YetAnotherElectronicsChannel/AES50/Hardware Design/KiCad Files/aes50_trion.kicad_pcb

## KiCad design Hardware Design/KiCad Files/aes50_trion.kicad_pcb (2026-08-12)

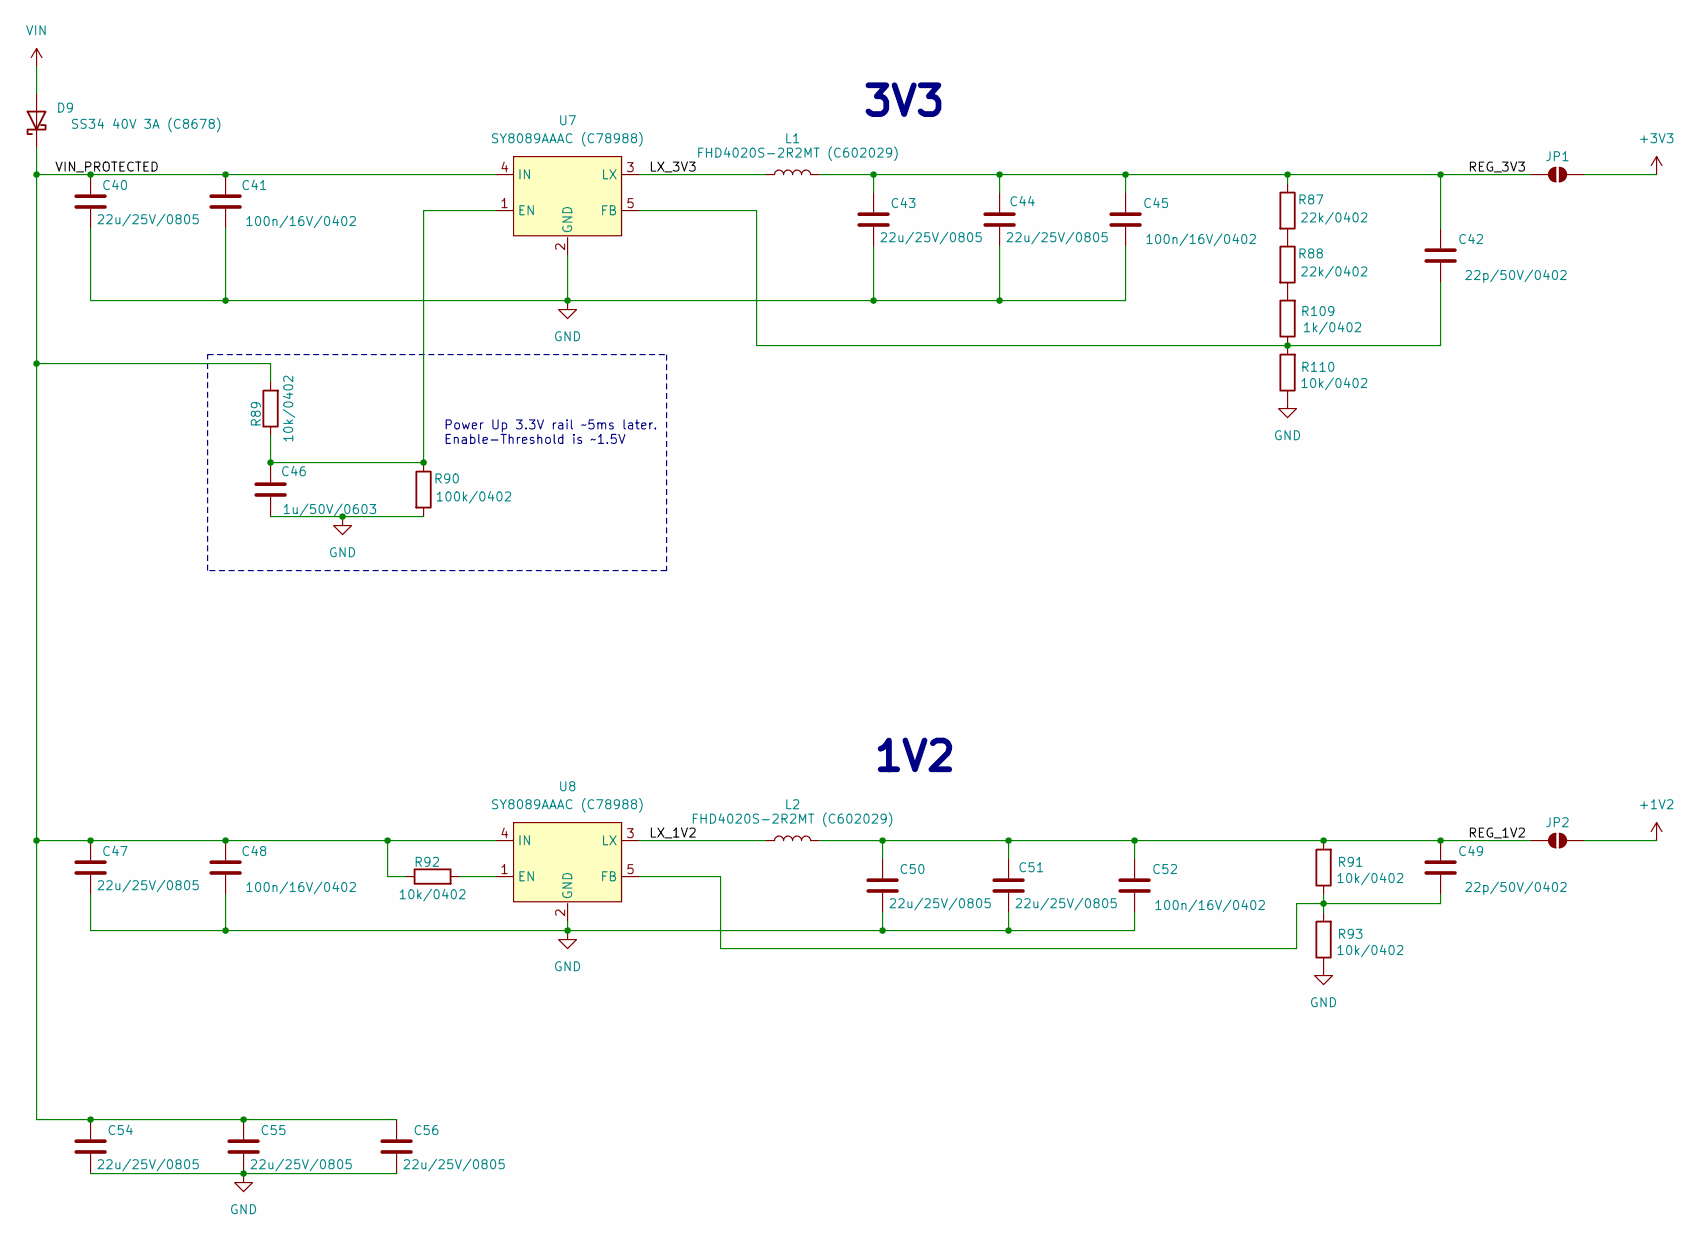
[picture p6: schematic Power.kicad_sch]

Parts:
C40, C43, C44, C47, C50, C51, C54, C55, C56: 22u/25V/0805; C_0805_2012Metric
C41, C45, C48, C52: 100n/16V/0402; C_0402_1005Metric
C42, C49: 22p/50V/0402; C_0402_1005Metric
C46: 1u/50V/0603; C_0603_1608Metric
D9: SS34 40V 3A (C8678); D_SMA
JP1, JP2: SolderJumper_2_Open; SolderJumper-2_P1.3mm_Open_RoundedPad1.0x1.5mm
L1, L2: FHD4020S-2R2MT (C602029); L_APV_ANR4020
R87, R88: 22k/0402; R_0402_1005Metric
R89, R91, R92, R93, R110: 10k/0402; R_0402_1005Metric
R90: 100k/0402; R_0402_1005Metric
R109: 1k/0402; R_0402_1005Metric
U7, U8: SY8089AAAC (C78988); SOT-23-5

Connections:
+1V2: JP2.2 (B); also elsewhere on the board
+3V3: JP1.2 (B); also elsewhere on the board
/Power/LX_1V2: L2.1, U8.3 (LX)
/Power/LX_3V3: L1.1, U7.3 (LX)
/Power/REG_1V2: C49.1, C50.1, C51.1, C52.1, JP2.1 (A), L2.2, R91.2
/Power/REG_3V3: C42.1, C43.1, C44.1, C45.1, JP1.1 (A), L1.2, R87.1
/Power/VIN_PROTECTED: C40.1, C41.1, C47.1, C48.1, C54.1, C55.1, C56.1, D9.1 (K), R89.2, R92.1, U7.4 (IN), U8.4 (IN)
GND: C40.2, C41.2, C43.2, C44.2, C45.2, C46.1, C47.2, C48.2, C50.2, C51.2, C52.2, C54.2, C55.2, C56.2, R90.2, R93.1, R110.1, U7.2 (GND), U8.2 (GND); also elsewhere on the board
unnamed: R87.2, R88.1
unnamed: R88.2, R109.2
unnamed: C46.2, R89.1, R90.1, U7.1 (EN)
unnamed: C42.2, R109.1, R110.2, U7.5 (FB)
unnamed: R92.2, U8.1 (EN)
unnamed: C49.2, R91.1, R93.2, U8.5 (FB)
VIN: D9.2 (A); also elsewhere on the board

Notes on the sheet:
3V3
1V2
Power Up 3.3V rail ~5ms later. Enable-Threshold is ~1.5V

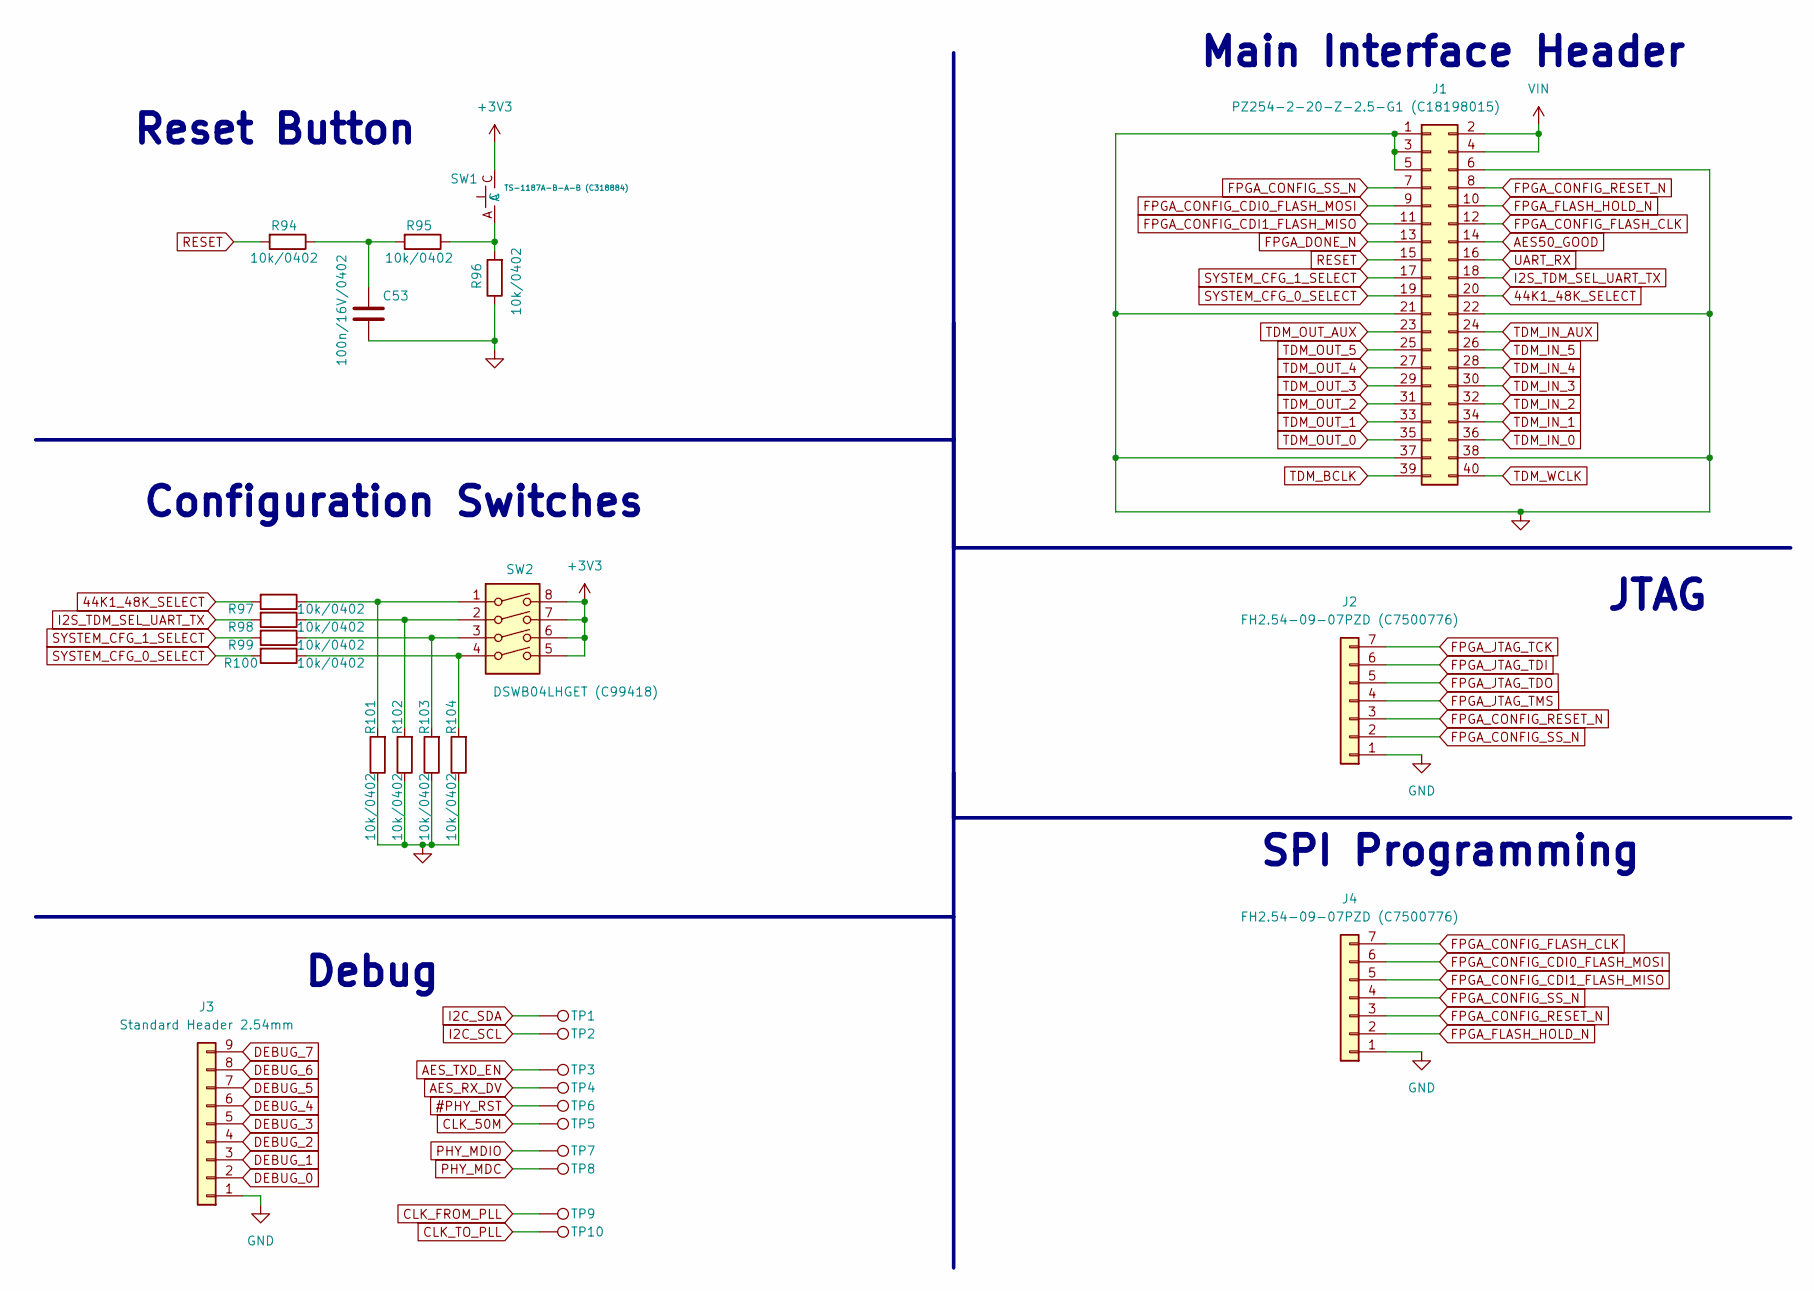
[picture p7: schematic Misc.kicad_sch]

Parts:
C53: 100n/16V/0402; C_0402_1005Metric
J1: PZ254-2-20-Z-2.5-G1 (C18198015); PinHeader_2x20_P2.54mm_Vertical
J2, J4: FH2.54-09-07PZD (C7500776); FH2.54-09-07PZD
J3: Standard Header 2.54mm; PinHeader_1x09_P2.54mm_Vertical
R94, R95, R96, R97, R98, R99, R100, R101, R102, R103, R104: 10k/0402; R_0402_1005Metric
SW1: TS-1187A-B-A-B (C318884); TS-1187A-B-A-B
SW2: DSWB04LHGET (C99418); DSWB04LHGET
TP1, TP2, TP3, TP4, TP5, TP6, TP7, TP8, TP9, TP10: TestPoint; TestPoint_Pad_D1.0mm

Connections:
44K1_48K_SELECT: J1.20, R97.2; also elsewhere on the board
#PHY_RST: TP6.1; also elsewhere on the board
+3V3: SW1.C, SW1.D, SW2.5, SW2.6, SW2.7, SW2.8; also elsewhere on the board
AES50_GOOD: J1.14; also elsewhere on the board
AES_RX_DV: TP4.1; also elsewhere on the board
AES_TXD_EN: TP3.1; also elsewhere on the board
CLK_50M: TP5.1; also elsewhere on the board
CLK_FROM_PLL: TP9.1; also elsewhere on the board
CLK_TO_PLL: TP10.1; also elsewhere on the board
DEBUG_0: J3.2; also elsewhere on the board
DEBUG_1: J3.3; also elsewhere on the board
DEBUG_2: J3.4; also elsewhere on the board
DEBUG_3: J3.5; also elsewhere on the board
DEBUG_4: J3.6; also elsewhere on the board
DEBUG_5: J3.7; also elsewhere on the board
DEBUG_6: J3.8; also elsewhere on the board
DEBUG_7: J3.9; also elsewhere on the board
FPGA_CONFIG_CDI0_FLASH_MOSI: J1.9, J4.6; also elsewhere on the board
FPGA_CONFIG_CDI1_FLASH_MISO: J1.11, J4.5; also elsewhere on the board
FPGA_CONFIG_FLASH_CLK: J1.12, J4.7; also elsewhere on the board
FPGA_CONFIG_RESET_N: J1.8, J2.3, J4.3; also elsewhere on the board
FPGA_CONFIG_SS_N: J1.7, J2.2, J4.4; also elsewhere on the board
FPGA_DONE_N: J1.13; also elsewhere on the board
FPGA_FLASH_HOLD_N: J1.10, J4.2; also elsewhere on the board
FPGA_JTAG_TCK: J2.7; also elsewhere on the board
FPGA_JTAG_TDI: J2.6; also elsewhere on the board
FPGA_JTAG_TDO: J2.5; also elsewhere on the board
FPGA_JTAG_TMS: J2.4; also elsewhere on the board
GND: C53.2, J1.1, J1.3, J1.5, J1.6, J1.21, J1.22, J1.37, J1.38, J2.1, J3.1, J4.1, R96.1, R101.1, R102.1, R103.1, R104.1; also elsewhere on the board
I2C_SCL: TP2.1; also elsewhere on the board
I2C_SDA: TP1.1; also elsewhere on the board
unnamed: C53.1, R94.1, R95.2
unnamed: R95.1, R96.2, SW1.A, SW1.B
unnamed: R100.1, R104.2, SW2.4
unnamed: R97.1, R101.2, SW2.1
unnamed: R98.1, R102.2, SW2.2
unnamed: R99.1, R103.2, SW2.3
PHY_MDC: TP8.1; also elsewhere on the board
PHY_MDIO: TP7.1; also elsewhere on the board
RESET: J1.15, R94.2; also elsewhere on the board
SPARE_SELECT_GPIO: J1.18, R98.2; also elsewhere on the board
SYSTEM_CFG_0_SELECT: J1.19, R100.2; also elsewhere on the board
SYSTEM_CFG_1_SELECT: J1.17, R99.2; also elsewhere on the board
TDM_BCLK: J1.39; also elsewhere on the board
TDM_IN_0: J1.36; also elsewhere on the board
TDM_IN_1: J1.34; also elsewhere on the board
TDM_IN_2: J1.32; also elsewhere on the board
TDM_IN_3: J1.30; also elsewhere on the board
TDM_IN_4: J1.28; also elsewhere on the board
TDM_IN_5: J1.26; also elsewhere on the board
TDM_IN_AUX: J1.24; also elsewhere on the board
TDM_OUT_0: J1.35; also elsewhere on the board
TDM_OUT_1: J1.33; also elsewhere on the board
TDM_OUT_2: J1.31; also elsewhere on the board
TDM_OUT_3: J1.29; also elsewhere on the board
TDM_OUT_4: J1.27; also elsewhere on the board
TDM_OUT_5: J1.25; also elsewhere on the board
TDM_OUT_AUX: J1.23; also elsewhere on the board
TDM_WCLK: J1.40; also elsewhere on the board
UART_TX: J1.16; also elsewhere on the board
VIN: J1.2, J1.4; also elsewhere on the board

Notes on the sheet:
Reset Button
Main Interface Header
Configuration Switches
JTAG
SPI Programming
Debug

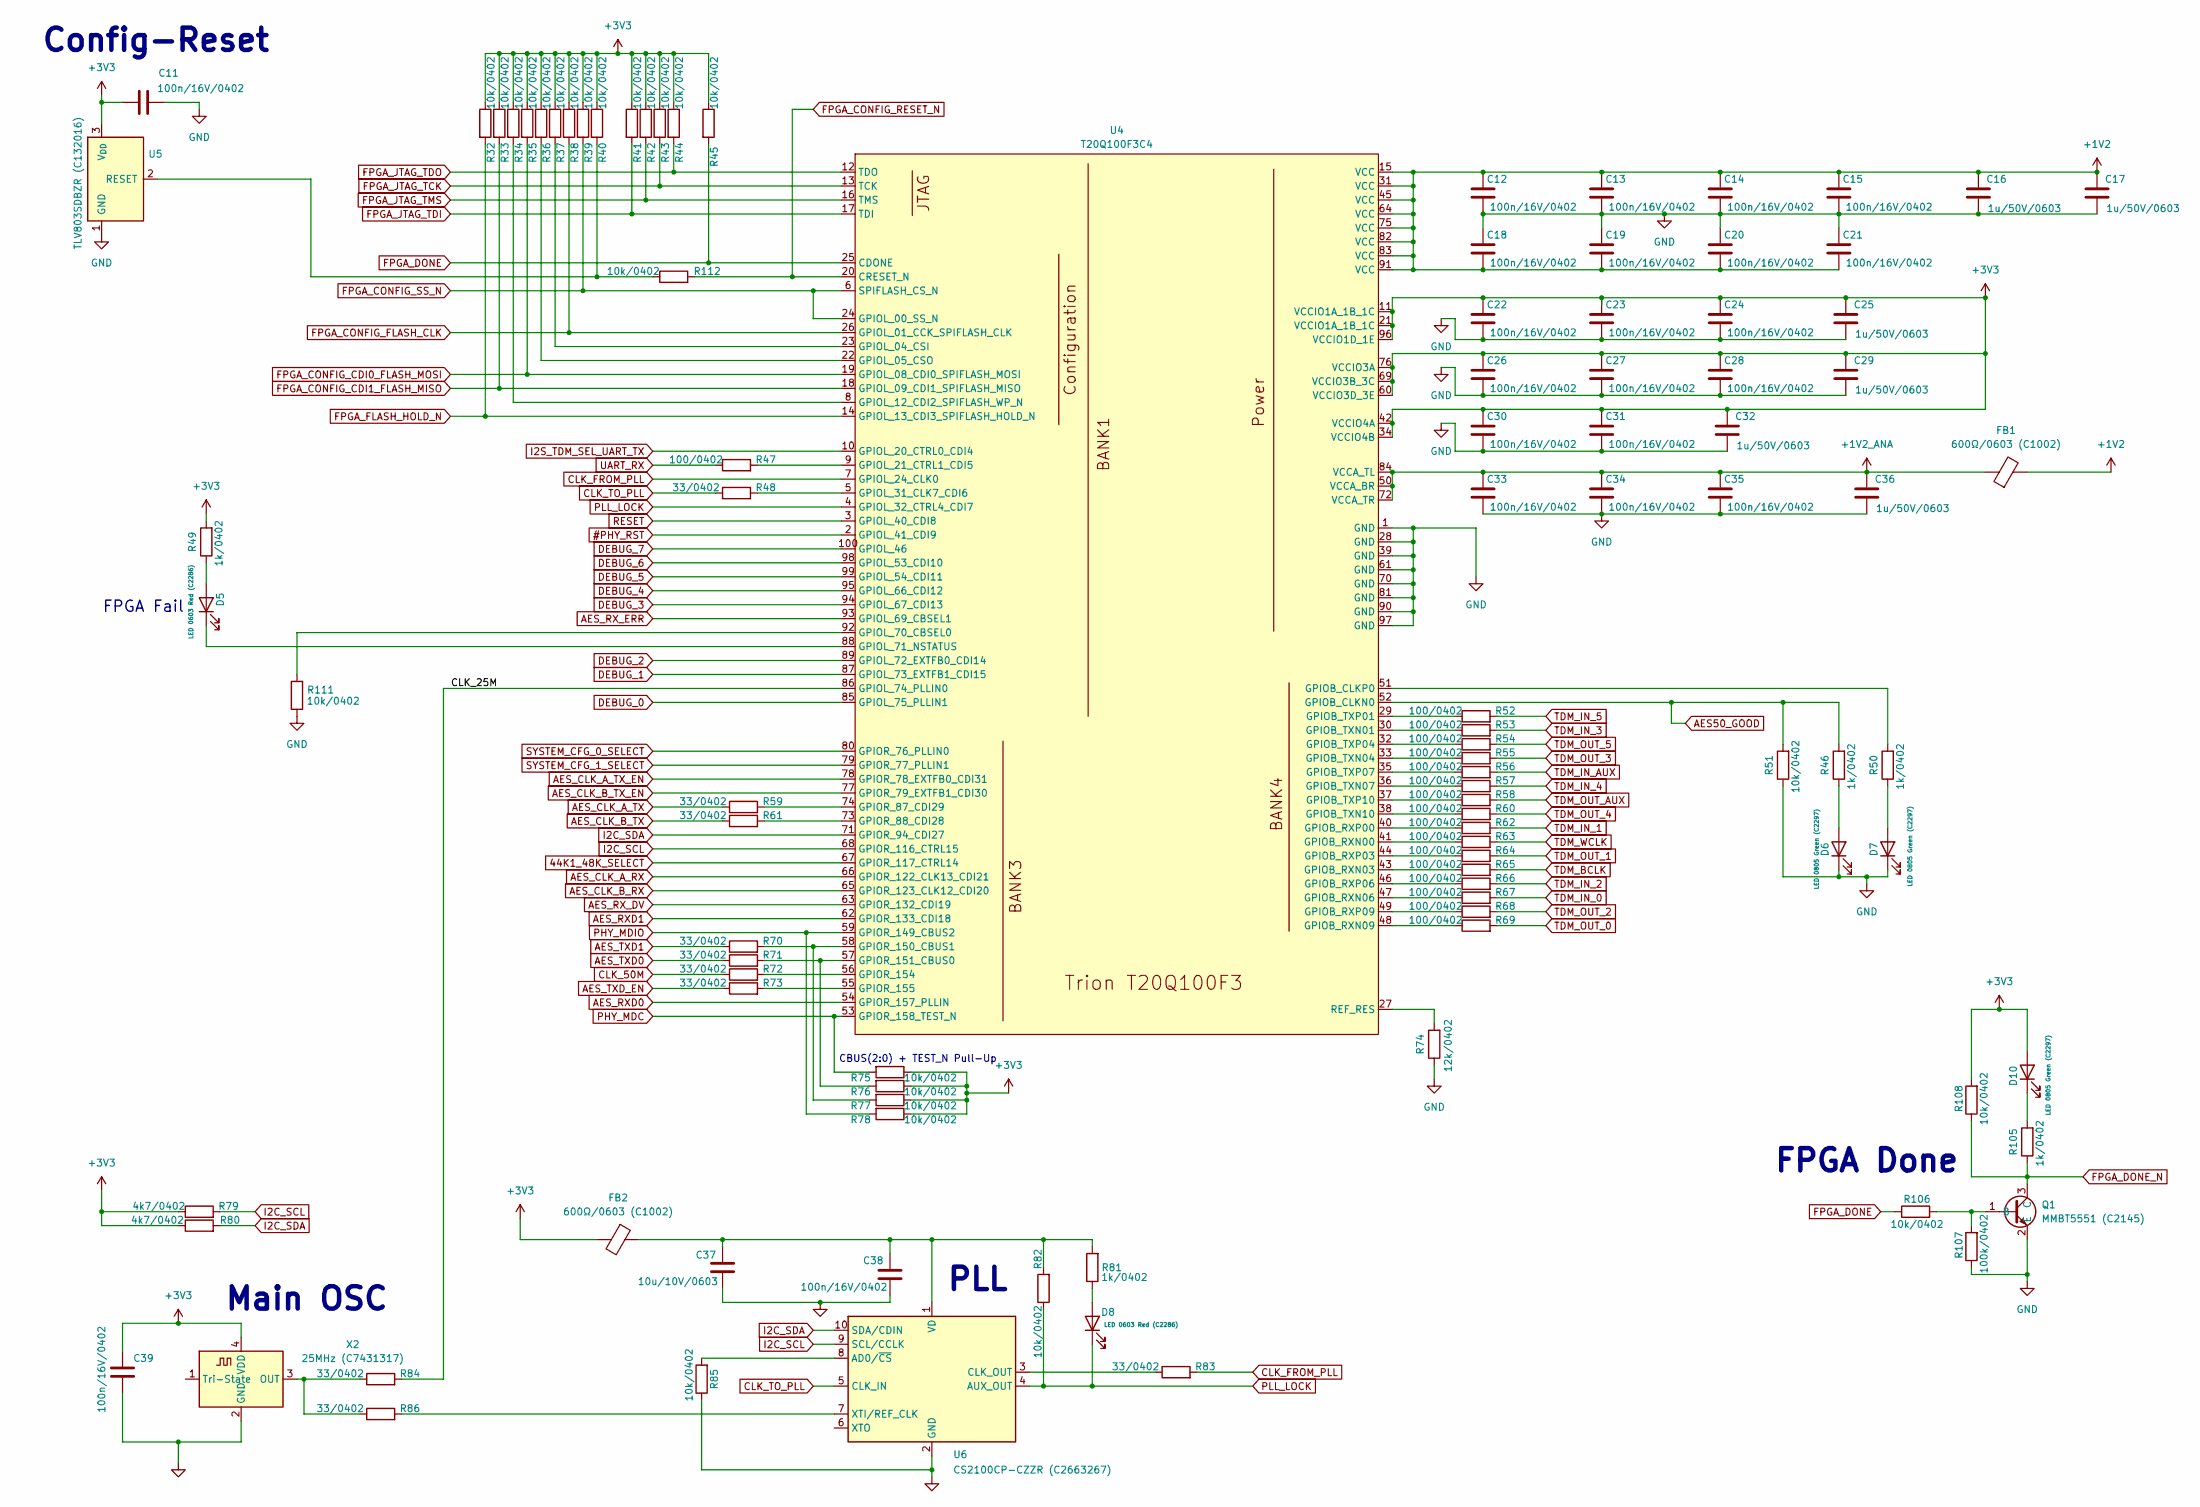
[picture p8: schematic fpga.kicad_sch]

Parts:
C11, C12, C13, C14, C15, C18, C19, C20, C21, C22, C23, C24, C26, C27, C28, C30, C31, C33, C34, C35, C38, C39: 100n/16V/0402; C_0402_1005Metric
C16, C17, C25, C29, C32, C36: 1u/50V/0603; C_0603_1608Metric
C37: 10u/10V/0603; C_0603_1608Metric
D5, D8: LED 0603 Red (C2286); LED_0603_1608Metric
D6, D7, D10: LED 0805 Green (C2297); LED_0805_2012Metric
FB1, FB2: 600Ω/0603 (C1002); L_0603_1608Metric
Q1: MMBT5551 (C2145); SOT-23
R32, R33, R34, R35, R36, R37, R38, R39, R40, R41, R42, R43, R44, R45, R51, R75, R76, R77, R78, R82, R85, R106, R108, R111, R112: 10k/0402; R_0402_1005Metric
R46, R49, R50, R81, R105: 1k/0402; R_0402_1005Metric
R47, R52, R53, R54, R55, R56, R57, R58, R60, R62, R63, R64, R65, R66, R67, R68, R69: 100/0402; R_0402_1005Metric
R48, R59, R61, R70, R71, R72, R73, R83, R84, R86: 33/0402; R_0402_1005Metric
R74: 12k/0402; R_0402_1005Metric
R79, R80: 4k7/0402; R_0402_1005Metric
R107: 100k/0402; R_0402_1005Metric
U4: T20Q100F3C4; LQFP-100_14x14mm_P0.5mm
U5: TLV803SDBZR (C132016); SOT-23
U6: CS2100CP-CZZR (C2663267); MSOP-10_3x3mm_P0.5mm
X2: 25MHz (C7431317); Oscillator_SMD_ECS_2520MV-xxx-xx-4Pin_2.5x2.0mm

Connections:
44K1_48K_SELECT: U4.67 (GPIOR_117_CTRL14); also elsewhere on the board
#PHY_RST: U4.2 (GPIOL_41_CDI9); also elsewhere on the board
+1V2: C12.2, C13.2, C14.2, C15.2, C16.2, C17.2, C18.1, C19.1, C20.1, C21.1, FB1.2, U4.15 (VCC), U4.31 (VCC), U4.45 (VCC), U4.64 (VCC), U4.75 (VCC), U4.82 (VCC), U4.83 (VCC), U4.91 (VCC); also elsewhere on the board
+1V2_ANA: C33.2, C34.2, C35.2, C36.2, FB1.1, U4.50 (VCCA_BR), U4.72 (VCCA_TR), U4.84 (VCCA_TL)
+3V3: C11.2, C22.2, C23.2, C24.2, C25.2, C26.2, C27.2, C28.2, C29.2, C30.2, C31.2, C32.2, C39.1, D10.2 (A), FB2.2, R32.1, R33.1, R34.1, R35.1, R36.1, R37.1, R38.1, R39.1, R40.1, R41.1, R42.1, R43.1, R44.1, R45.1, R49.2, R75.1, R76.1, R77.1, R78.1, R79.1, R80.1, R108.2, U4.11 (VCCIO1A_1B_1C), U4.21 (VCCIO1A_1B_1C), U4.34 (VCCIO4B), U4.42 (VCCIO4A), U4.60 (VCCIO3D_3E), U4.69 (VCCIO3B_3C), U4.76 (VCCIO3A), U4.96 (VCCIO1D_1E), U5.3 (V_{DD}), X2.4 (VDD); also elsewhere on the board
/FPGA/CLK_25M: R84.2, U4.86 (GPIOL_74_PLLIN0)
AES50_GOOD: R46.2, R51.2, U4.52 (GPIOB_CLKN0); also elsewhere on the board
AES_CLK_A_RX: U4.66 (GPIOR_122_CLK13_CDI21); also elsewhere on the board
AES_CLK_A_TX: R59.1; also elsewhere on the board
AES_CLK_A_TX_EN: U4.78 (GPIOR_78_EXTFB0_CDI31); also elsewhere on the board
AES_CLK_B_RX: U4.65 (GPIOR_123_CLK12_CDI20); also elsewhere on the board
AES_CLK_B_TX: R61.1; also elsewhere on the board
AES_CLK_B_TX_EN: U4.77 (GPIOR_79_EXTFB1_CDI30); also elsewhere on the board
AES_RXD0: U4.54 (GPIOR_157_PLLIN); also elsewhere on the board
AES_RXD1: U4.62 (GPIOR_133_CDI18); also elsewhere on the board
AES_RX_DV: U4.63 (GPIOR_132_CDI19); also elsewhere on the board
AES_RX_ERR: U4.93 (GPIOL_69_CBSEL1); also elsewhere on the board
AES_TXD0: R71.1; also elsewhere on the board
AES_TXD1: R70.1; also elsewhere on the board
AES_TXD_EN: R73.1; also elsewhere on the board
CLK_50M: R72.1; also elsewhere on the board
CLK_FROM_PLL: R83.2, U4.7 (GPIOL_24_CLK0); also elsewhere on the board
CLK_TO_PLL: R48.1, U6.5 (CLK_IN); also elsewhere on the board
DEBUG_0: U4.85 (GPIOL_75_PLLIN1); also elsewhere on the board
DEBUG_1: U4.87 (GPIOL_73_EXTFB1_CDI15); also elsewhere on the board
DEBUG_2: U4.89 (GPIOL_72_EXTFB0_CDI14); also elsewhere on the board
DEBUG_3: U4.94 (GPIOL_67_CDI13); also elsewhere on the board
DEBUG_4: U4.95 (GPIOL_66_CDI12); also elsewhere on the board
DEBUG_5: U4.99 (GPIOL_54_CDI11); also elsewhere on the board
DEBUG_6: U4.98 (GPIOL_53_CDI10); also elsewhere on the board
DEBUG_7: U4.100 (GPIOL_46); also elsewhere on the board
FPGA_CONFIG_CDI0_FLASH_MOSI: R35.2, U4.19 (GPIOL_08_CDI0_SPIFLASH_MOSI); also elsewhere on the board
FPGA_CONFIG_CDI1_FLASH_MISO: R33.2, U4.18 (GPIOL_09_CDI1_SPIFLASH_MISO); also elsewhere on the board
FPGA_CONFIG_FLASH_CLK: R38.2, U4.26 (GPIOL_01_CCK_SPIFLASH_CLK); also elsewhere on the board
FPGA_CONFIG_RESET_N: R112.2, U4.20 (CRESET_N); also elsewhere on the board
FPGA_CONFIG_SS_N: R39.2, U4.6 (SPIFLASH_CS_N), U4.24 (GPIOL_00_SS_N); also elsewhere on the board
FPGA_DONE: R45.2, R106.1, U4.25 (CDONE)
FPGA_DONE_N: Q1.3 (C), R105.1, R108.1; also elsewhere on the board
FPGA_FLASH_HOLD_N: R32.2, U4.14 (GPIOL_13_CDI3_SPIFLASH_HOLD_N); also elsewhere on the board
FPGA_JTAG_TCK: R43.2, U4.13 (TCK); also elsewhere on the board
FPGA_JTAG_TDI: R41.2, U4.17 (TDI); also elsewhere on the board
FPGA_JTAG_TDO: R44.2, U4.12 (TDO); also elsewhere on the board
FPGA_JTAG_TMS: R42.2, U4.16 (TMS); also elsewhere on the board
GND: C11.1, C12.1, C13.1, C14.1, C15.1, C16.1, C17.1, C18.2, C19.2, C20.2, C21.2, C22.1, C23.1, C24.1, C25.1, C26.1, C27.1, C28.1, C29.1, C30.1, C31.1, C32.1, C33.1, C34.1, C35.1, C36.1, C37.1, C38.2, C39.2, D6.1 (K), D7.1 (K), Q1.2 (E), R51.1, R74.1, R85.1, R107.1, R111.1, U4.1 (GND), U4.28 (GND), U4.39 (GND), U4.61 (GND), U4.70 (GND), U4.81 (GND), U4.90 (GND), U4.97 (GND), U5.1 (GND), U6.2 (GND), X2.2 (GND); also elsewhere on the board
I2C_SCL: R79.2, U4.68 (GPIOR_116_CTRL15), U6.9 (SCL/CCLK); also elsewhere on the board
I2C_SDA: R80.2, U4.71 (GPIOR_94_CDI27), U6.10 (SDA/CDIN); also elsewhere on the board
unnamed: D5.2 (A), R49.1
unnamed: D5.1 (K), U4.88 (GPIOL_71_NSTATUS)
unnamed: D6.2 (A), R46.1
unnamed: D7.2 (A), R50.1
unnamed: D8.2 (A), R81.1
unnamed: D10.1 (K), R105.2
unnamed: Q1.1 (B), R106.2, R107.2
unnamed: R50.2, U4.51 (GPIOB_CLKP0)
unnamed: R63.1, U4.41 (GPIOB_RXN00)
unnamed: R65.1, U4.43 (GPIOB_RXN03)
unnamed: R67.1, U4.47 (GPIOB_RXN06)
unnamed: R69.1, U4.48 (GPIOB_RXN09)
unnamed: R62.1, U4.40 (GPIOB_RXP00)
unnamed: R64.1, U4.44 (GPIOB_RXP03)
unnamed: R66.1, U4.46 (GPIOB_RXP06)
unnamed: R68.1, U4.49 (GPIOB_RXP09)
unnamed: R53.1, U4.30 (GPIOB_TXN01)
unnamed: R55.1, U4.33 (GPIOB_TXN04)
unnamed: R57.1, U4.36 (GPIOB_TXN07)
unnamed: R60.1, U4.38 (GPIOB_TXN10)
unnamed: R52.1, U4.29 (GPIOB_TXP01)
unnamed: R54.1, U4.32 (GPIOB_TXP04)
unnamed: R56.1, U4.35 (GPIOB_TXP07)
unnamed: R58.1, U4.37 (GPIOB_TXP10)
unnamed: R37.2, U4.23 (GPIOL_04_CSI)
unnamed: R36.2, U4.22 (GPIOL_05_CSO)
unnamed: R34.2, U4.8 (GPIOL_12_CDI2_SPIFLASH_WP_N)
unnamed: R47.2, U4.9 (GPIOL_21_CTRL1_CDI5)
unnamed: R48.2, U4.5 (GPIOL_31_CLK7_CDI6)
unnamed: R111.2, U4.92 (GPIOL_70_CBSEL0)
unnamed: R59.2, U4.74 (GPIOR_87_CDI29)
unnamed: R61.2, U4.73 (GPIOR_88_CDI28)
unnamed: R70.2, R77.2, U4.58 (GPIOR_150_CBUS1)
unnamed: R71.2, R76.2, U4.57 (GPIOR_151_CBUS0)
unnamed: R72.2, U4.56 (GPIOR_154)
unnamed: R73.2, U4.55 (GPIOR_155)
unnamed: R74.2, U4.27 (REF_RES)
unnamed: R40.2, R112.1, U5.2 (RESET)
unnamed: R85.2, U6.8 (AD0/~CS)
unnamed: R83.1, U6.3 (CLK_OUT)
unnamed: C37.2, C38.1, FB2.1, R81.2, R82.2, U6.1 (VD)
unnamed: R86.2, U6.7 (XTI/REF_CLK)
unnamed: R84.1, R86.1, X2.3 (OUT)
PHY_MDC: R75.2, U4.53 (GPIOR_158_TEST_N); also elsewhere on the board
PHY_MDIO: R78.2, U4.59 (GPIOR_149_CBUS2); also elsewhere on the board
PLL_LOCK: D8.1 (K), R82.1, U4.4 (GPIOL_32_CTRL4_CDI7), U6.4 (AUX_OUT)
RESET: U4.3 (GPIOL_40_CDI8); also elsewhere on the board
SPARE_SELECT_GPIO: U4.10 (GPIOL_20_CTRL0_CDI4); also elsewhere on the board
SYSTEM_CFG_0_SELECT: U4.80 (GPIOR_76_PLLIN0); also elsewhere on the board
SYSTEM_CFG_1_SELECT: U4.79 (GPIOR_77_PLLIN1); also elsewhere on the board
TDM_BCLK: R65.2; also elsewhere on the board
TDM_IN_0: R67.2; also elsewhere on the board
TDM_IN_1: R62.2; also elsewhere on the board
TDM_IN_2: R66.2; also elsewhere on the board
TDM_IN_3: R53.2; also elsewhere on the board
TDM_IN_4: R57.2; also elsewhere on the board
TDM_IN_5: R52.2; also elsewhere on the board
TDM_IN_AUX: R56.2; also elsewhere on the board
TDM_OUT_0: R69.2; also elsewhere on the board
TDM_OUT_1: R64.2; also elsewhere on the board
TDM_OUT_2: R68.2; also elsewhere on the board
TDM_OUT_3: R55.2; also elsewhere on the board
TDM_OUT_4: R60.2; also elsewhere on the board
TDM_OUT_5: R54.2; also elsewhere on the board
TDM_OUT_AUX: R58.2; also elsewhere on the board
TDM_WCLK: R63.2; also elsewhere on the board
UART_TX: R47.1; also elsewhere on the board

Notes on the sheet:
PLL
FPGA Fail
Main OSC
Config-Reset
FPGA Done
CBUS(2:0) + TEST_N Pull-Up

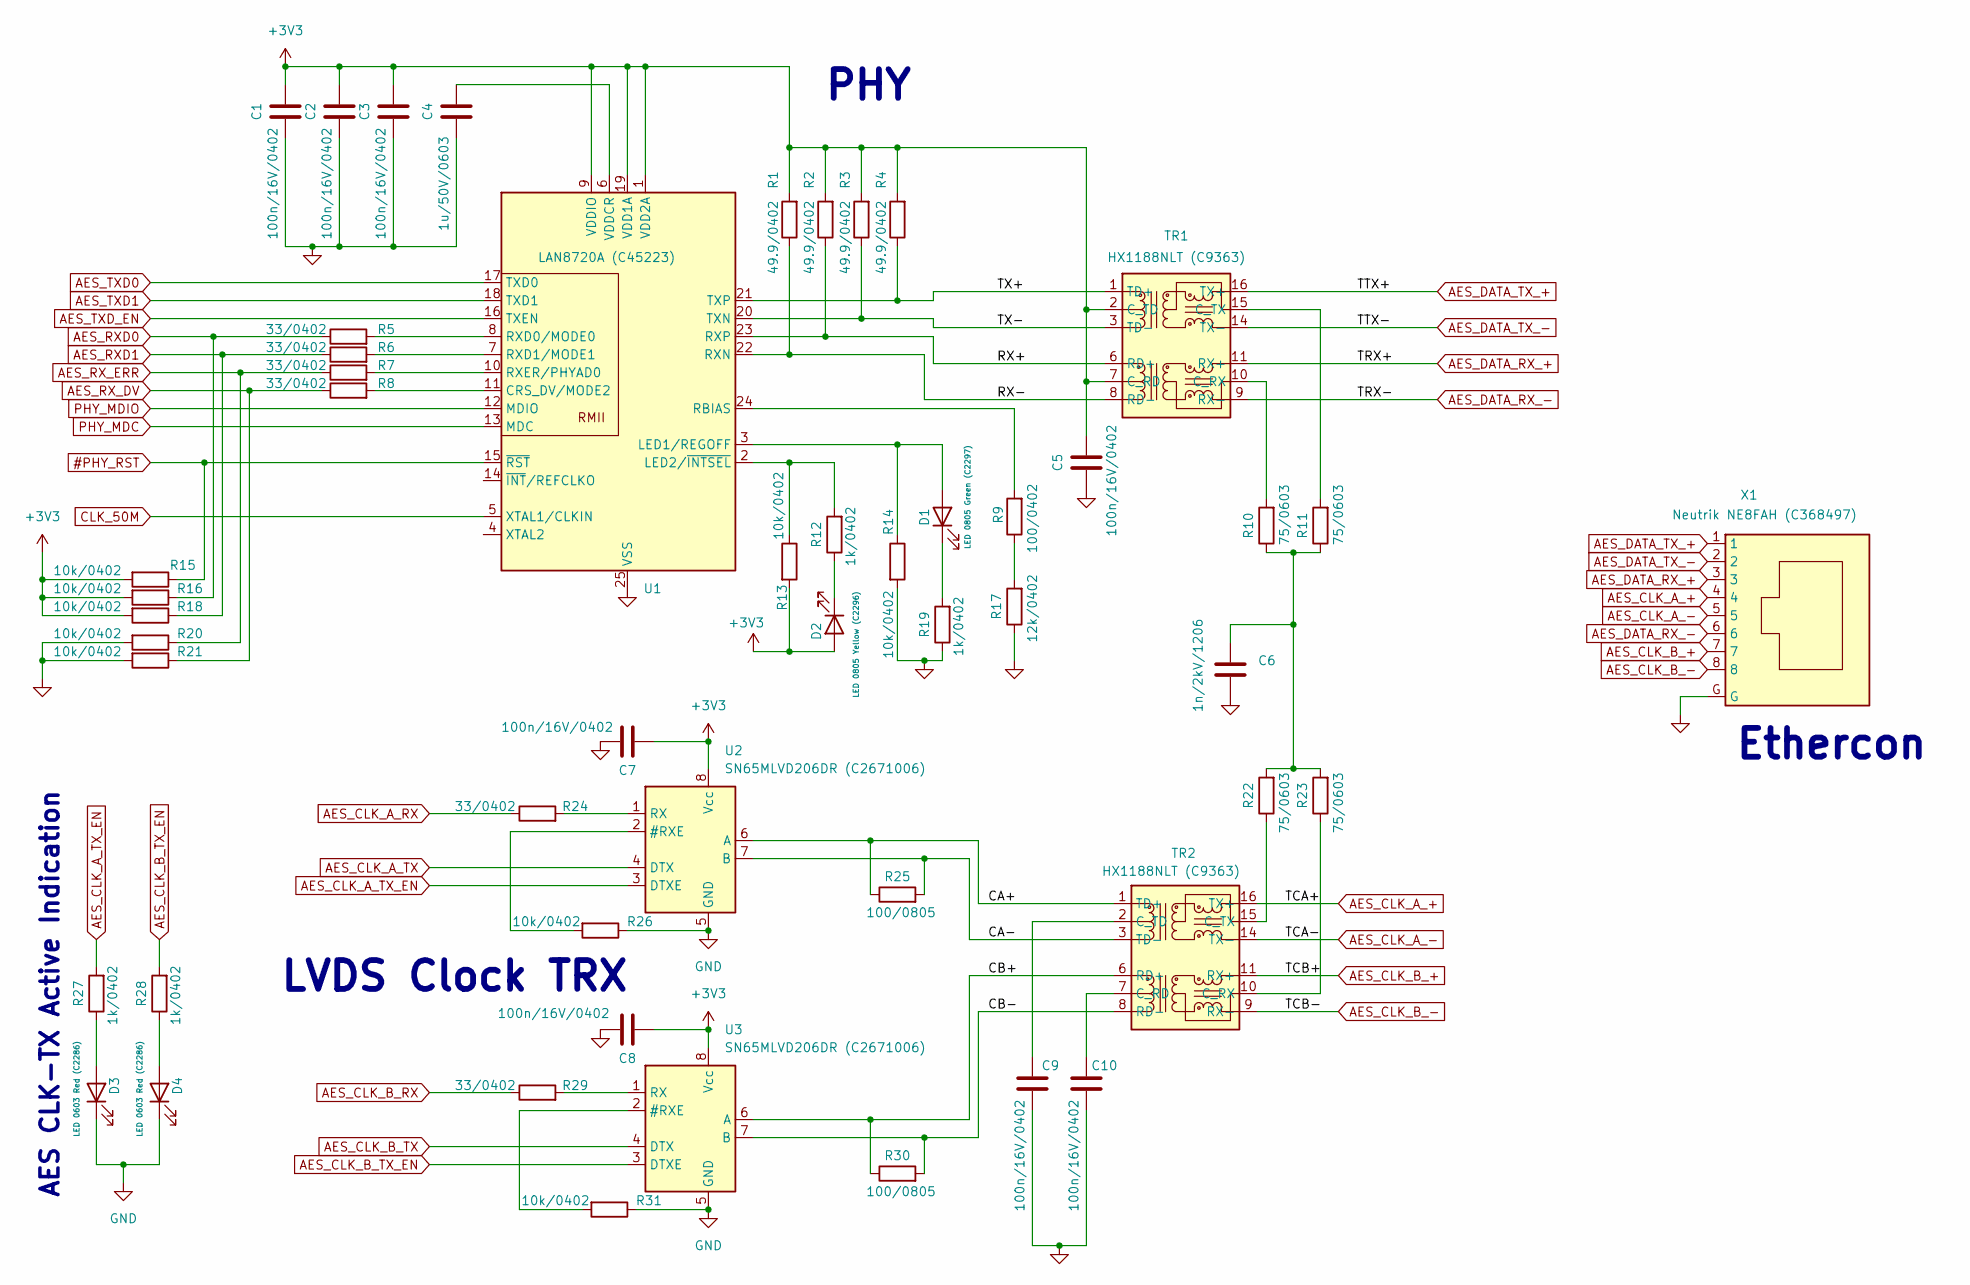
[picture p9: schematic AES50_FrontEnd.kicad_sch]

Parts:
C1, C2, C3, C5, C7, C8, C9, C10: 100n/16V/0402; C_0402_1005Metric
C4: 1u/50V/0603; C_0603_1608Metric
C6: 1n/2kV/1206; C_1206_3216Metric
D1: LED 0805 Green (C2297); LED_0805_2012Metric
D2: LED 0805 Yellow (C2296); LED_0805_2012Metric
D3, D4: LED 0603 Red (C2286); LED_0603_1608Metric
R1, R2, R3, R4: 49.9/0402; R_0402_1005Metric
R5, R6, R7, R8, R24, R29: 33/0402; R_0402_1005Metric
R9: 100/0402; R_0402_1005Metric
R10, R11, R22, R23: 75/0603; R_0603_1608Metric
R12, R19, R27, R28: 1k/0402; R_0402_1005Metric
R13, R14, R15, R16, R18, R20, R21, R26, R31: 10k/0402; R_0402_1005Metric
R17: 12k/0402; R_0402_1005Metric
R25, R30: 100/0805; R_0805_2012Metric
TR1, TR2: HX1188NLT (C9363); HX1188NL
U1: LAN8720A (C45223); VQFN-24-1EP_4x4mm_P0.5mm_EP2.5x2.5mm_ThermalVias
U2, U3: SN65MLVD206DR (C2671006); SOIC-8_3.9x4.9mm_P1.27mm
X1: Neutrik NE8FAH (C368497); Neutrik NE8FAH

Connections:
#PHY_RST: R15.1, U1.15 (~RST); also elsewhere on the board
+3V3: C1.2, C2.2, C3.2, C5.2, C7.1, C8.1, D2.2 (A), R1.2, R2.2, R3.2, R4.2, R13.2, R15.2, R16.2, R18.2, TR1.2 (C_TD), TR1.7 (C_RD), U1.1 (VDD2A), U1.9 (VDDIO), U1.19 (VDD1A), U2.8 (Vcc), U3.8 (Vcc); also elsewhere on the board
/AES50_FrontEnd/CA+: R25.1, TR2.1 (TD+), U2.6 (A)
/AES50_FrontEnd/CA-: R25.2, TR2.3 (TD-), U2.7 (B)
/AES50_FrontEnd/CB+: R30.1, TR2.6 (RD+), U3.6 (A)
/AES50_FrontEnd/CB-: R30.2, TR2.8 (RD-), U3.7 (B)
/AES50_FrontEnd/RX+: R2.1, TR1.6 (RD+), U1.23 (RXP)
/AES50_FrontEnd/RX-: R1.1, TR1.8 (RD-), U1.22 (RXN)
/AES50_FrontEnd/TX+: R4.1, TR1.1 (TD+), U1.21 (TXP)
/AES50_FrontEnd/TX-: R3.1, TR1.3 (TD-), U1.20 (TXN)
AES_CLK_A_+: TR2.16 (TX+), X1.4
AES_CLK_A_-: TR2.14 (TX-), X1.5
AES_CLK_A_RX: R24.1; also elsewhere on the board
AES_CLK_A_TX: U2.4 (DTX); also elsewhere on the board
AES_CLK_A_TX_EN: R27.2, U2.3 (DTXE); also elsewhere on the board
AES_CLK_B_+: TR2.11 (RX+), X1.7
AES_CLK_B_-: TR2.9 (RX-), X1.8
AES_CLK_B_RX: R29.1; also elsewhere on the board
AES_CLK_B_TX: U3.4 (DTX); also elsewhere on the board
AES_CLK_B_TX_EN: R28.2, U3.3 (DTXE); also elsewhere on the board
AES_DATA_RX_+: TR1.11 (RX+), X1.3
AES_DATA_RX_-: TR1.9 (RX-), X1.6
AES_DATA_TX_+: TR1.16 (TX+), X1.1
AES_DATA_TX_-: TR1.14 (TX-), X1.2
AES_RXD0: R5.1, R16.1; also elsewhere on the board
AES_RXD1: R6.1, R18.1; also elsewhere on the board
AES_RX_DV: R8.1, R21.1; also elsewhere on the board
AES_RX_ERR: R7.1, R20.1; also elsewhere on the board
AES_TXD0: U1.17 (TXD0); also elsewhere on the board
AES_TXD1: U1.18 (TXD1); also elsewhere on the board
AES_TXD_EN: U1.16 (TXEN); also elsewhere on the board
CLK_50M: U1.5 (XTAL1/CLKIN); also elsewhere on the board
GND: C1.1, C2.1, C3.1, C4.1, C5.1, C6.2, C7.2, C8.2, C9.1, C10.1, D3.1 (K), D4.1 (K), R14.2, R17.1, R19.1, R20.2, R21.2, R26.1, R31.1, U1.25 (VSS), U2.5 (GND), U3.5 (GND), X1.G; also elsewhere on the board
unnamed: C6.1, R10.1, R11.1, R22.2, R23.2
unnamed: D1.2 (A), R14.1, U1.3 (LED1/REGOFF)
unnamed: D1.1 (K), R19.2
unnamed: D2.1 (K), R12.1
unnamed: D3.2 (A), R27.1
unnamed: D4.2 (A), R28.1
unnamed: R9.1, R17.2
unnamed: R10.2, TR1.10 (C_RX)
unnamed: R11.2, TR1.15 (C_TX)
unnamed: C10.2, TR2.7 (C_RD)
unnamed: R23.1, TR2.10 (C_RX)
unnamed: C9.2, TR2.2 (C_TD)
unnamed: R22.1, TR2.15 (C_TX)
unnamed: R8.2, U1.11 (CRS_DV/MODE2)
unnamed: R12.2, R13.1, U1.2 (LED2/~INTSEL)
unnamed: R9.2, U1.24 (RBIAS)
unnamed: R5.2, U1.8 (RXD0/MODE0)
unnamed: R6.2, U1.7 (RXD1/MODE1)
unnamed: R7.2, U1.10 (RXER/PHYAD0)
unnamed: C4.2, U1.6 (VDDCR)
unnamed: R26.2, U2.2 (#RXE)
unnamed: R24.2, U2.1 (RX)
unnamed: R31.2, U3.2 (#RXE)
unnamed: R29.2, U3.1 (RX)
PHY_MDC: U1.13 (MDC); also elsewhere on the board
PHY_MDIO: U1.12 (MDIO); also elsewhere on the board

Notes on the sheet:
AES CLK-TX Active Indication
LVDS Clock TRX
PHY
Ethercon

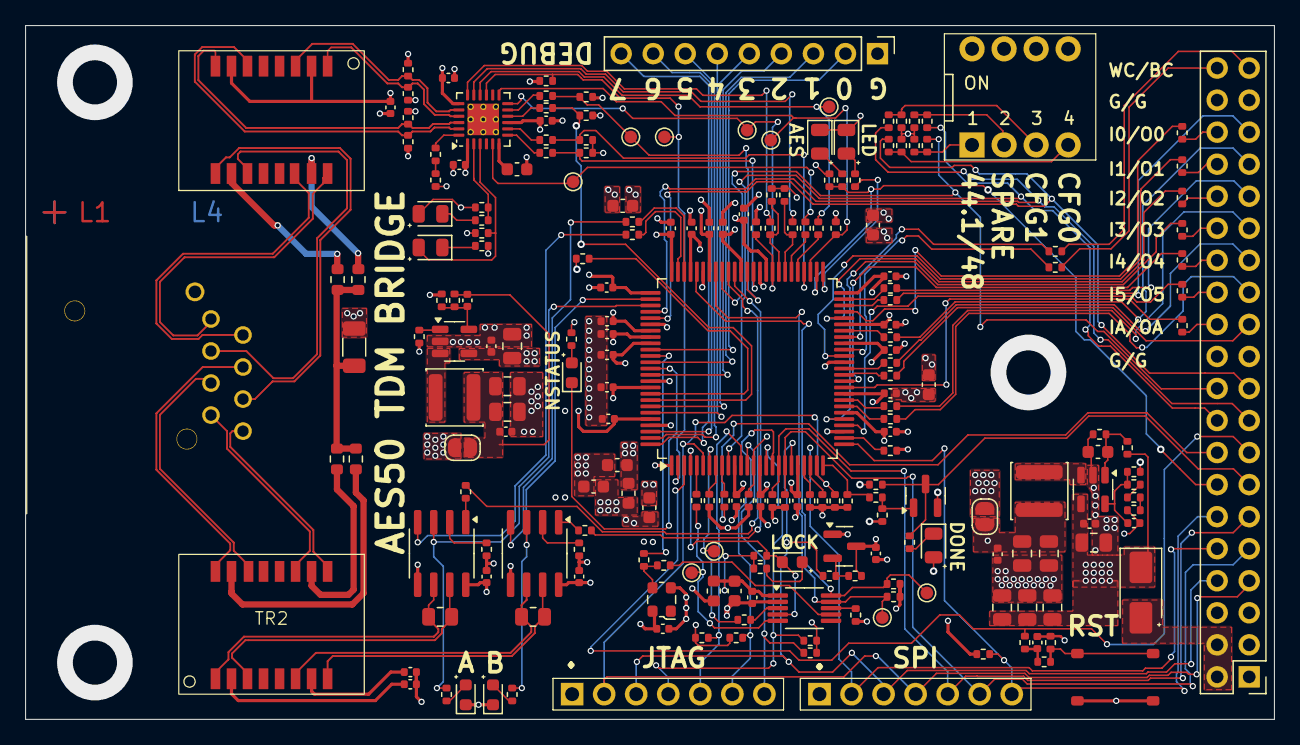
[picture p10: board aes50_trion.kicad_pcb from above]

Board: 4 copper layers, 99.0 x 55.0 mm, 213 parts (0 on the bottom side), 171 nets.
