YetAnotherElectronicsChannel/AES50/(commit log)

2026-03-05 Added AUX-tunnel data-decoder with UART-Output interface. Fixed interface-settings for RMII interface to Phy. Reverted clock-manager to async-reset version
    [aes50_aux_decoder.vhd, aes50_clockmanager.vhd, aes50_rx.vhd, aes50_top.vhd, aes50_tx.vhd, aes50_uart_tx.vhd, eval_aes50_top.vhd]
2026-03-26 Fix issue: Bit-Flips in Aux-Decoder
    [aes50_aux_decoder.vhd]
2026-03-26 Fix issue #1 from aspdigital
    [aes50_aux_decoder.vhd, aes50_clockmanager.vhd]
2026-05-05 Add missing Gerber-Files on request of issue #3
2026-08-12 Added KiCad Files
